wanghao6822/GL/Resource/Image/3.png

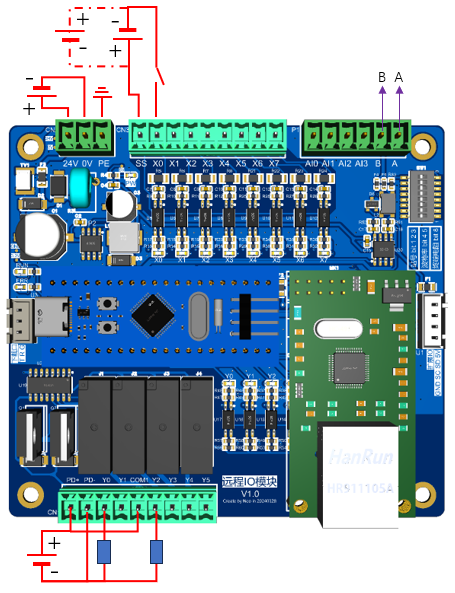
Resource/Image/3.png
