wanghao6822/GL/Resource/Image/1.jpg

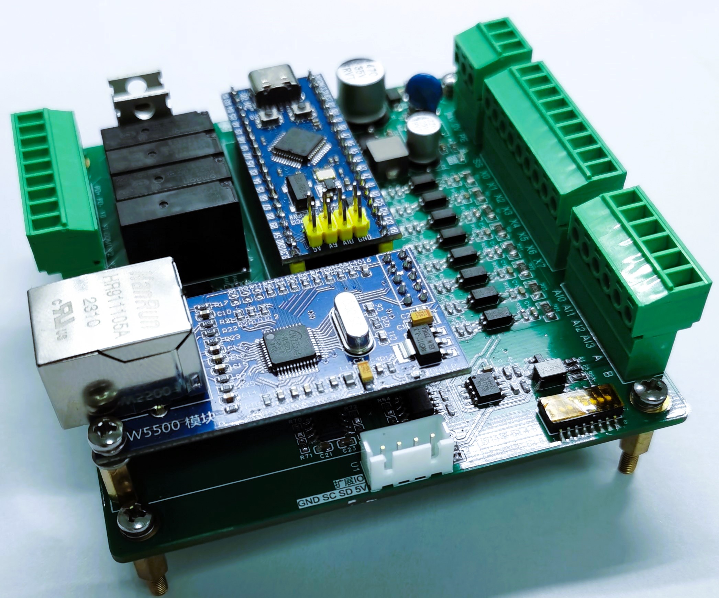
Resource/Image/1.jpg
