wanghao6822/GL/tools/项目参考文档.md

# 项目参考文档 — Modbus-IO 远程IO & 硅链调压器

> 本文档是从 `CLAUDE.md` 拆出的详细技术参考。需要完整寄存器定义、引脚表、控制算法时查阅。

---

## 技术栈

- **MCU**: STM32F103C8 (Cortex-M3)
- **框架**: Arduino + FreeRTOS
- **通信协议**: Modbus RTU (RS485) / Modbus TCP (Ethernet)
- **构建工具**: PlatformIO
- **语言**: C++

### 关键库

- Modbus-Arduino / Modbus-Serial / Modbus-Ethernet
- ADS1X15 (模拟量采集)
- PCF8575 (I2C 扩展 IO，预留)
- STM32duino FreeRTOS

---

## IO 引脚总表

### 数字输入（8路，低电平有效，已在 X_filter 任务中做消抖滤波）

| 名称 | 引脚 | 名称 | 引脚 |
| ---- | ---- | ---- | ---- |
| X0 | PB12 | X4 | PA8  |
| X1 | PB13 | X5 | PB0  |
| X2 | PB14 | X6 | PA11 |
| X3 | PB15 | X7 | PA12 |

### 数字输出（6路，开漏模式，LOW=导通/开启，HIGH=断开/关闭）

| 名称 | 引脚 | 当前用途 |
| ---- | ---- | --- |
| Y0 | PA15 | 报警输出（AlarmOutPin） |
| Y1 | PB3  | 通用输出 |
| Y2 | PB4  | 硅链控制继电器1 |
| Y3 | PB5  | 硅链控制继电器2 |
| Y4 | PB6  | 硅链控制继电器3 |
| Y5 | PB7  | 通用输出 |

### 拨码开关（5路，上拉输入，低电平=ON）

| 名称  | 引脚 | 功能 |
| ----- | ---- | --- |
| SW_B1 | PC15 | 站号 bit0 |
| SW_B2 | PA0  | 站号 bit1 |
| SW_B3 | PA1  | 站号 bit2 |
| SW_B4 | PA2  | 波特率 bit0 |
| SW_B5 | PA3  | 波特率 bit1 |

### 指示灯（开漏，低电平点亮）

| 名称 | 引脚 | 说明 |
| --- | ---- | --- |
| RUN_LED | PC14 | 每秒翻转 |
| ERROR_LED | PC13 | 看门狗复位后闪烁 |

### 通信与 I2C

| 名称 | 引脚 | 说明 |
| --- | ---- | --- |
| RS485 TX | PB10 | Modbus RTU 发送 |
| RS485 RX | PB11 | Modbus RTU 接收 |
| RS485 EN | PB1  | RS485 发送使能 |
| I2C SDA  | PB9  | ADS1115 + PCF8575 |
| I2C SCL  | PB8  | ADS1115 + PCF8575 |
| 调试 TX  | PA9  | 串口打印（需开启 UseSerialPrint 宏） |
| 调试 RX  | PA10 | 串口打印 |

---

## 模拟量输入（ADS1115，I2C 地址 0x48，增益 ±4.096V）

### 信号链路

```
高压直流(HM/KM) → 电阻分压(降压) → EXAI端子 → R64/R66(10kΩ) ─┬─→ LM358 IN+ → OUT → ADS1115 ADC
                                                     R65/R67(22kΩ)
                                                       │
                                                      GND
```

### 运放前端分压电路

| 通道 | 输入电阻 | 对地电阻 | 分压比 | 逆系数 |
|:----:|:---:|:---:|:---:|:---:|
| AI0 | R64=10kΩ | R65=22kΩ | 22/32=0.6875 | **1.4545** |
| AI1 | R66=10kΩ | R67=22kΩ | 22/32=0.6875 | **1.4545** |

### 转换公式

```
V_ADC    = ADC_value × 4.096 / 32767        (ADS1115增益=1, ±4.096V)
V_EXAI   = V_ADC × 1.4545                    (运放前端分压逆算)
V_bus    = V_EXAI × 校准系数                  (高压侧分压逆算，默认91倍)
```

即：`V_bus = ADC_value × 4.096 / 32767 × 1.4545 × calibration`

> **LM358 运放**：接成电压跟随器（OUT 直连 IN-），8脚接5V供电，4脚GND。

| 名称 | ADS1115 通道 | Modbus 寄存器 | 用途 |
| ---- | --- | --- | ---- |
| AI0  | 通道 0 | 寄存器 15 | 合母电压（HM，默认91:1分压，可通过寄存器31校准） |
| AI1  | 通道 1 | 寄存器 16 | 控母电压（KM，默认91:1分压，可通过寄存器32校准） |
| AI2  | 通道 2 | 寄存器 17 | 预留 |
| AI3  | 通道 3 | 寄存器 18 | 预留 |

---

## Modbus 保持寄存器完整映射（地址 0~32，RTU/TCP 共享）

### 基础 IO 寄存器（0~19，保持兼容）

| 地址 | 名称 | 读写 | 说明 |
| ---- | --- | ---- | --- |
| 0 | 固件版本 | R | 固定值 40501 |
| 1 | 从站 ID | R | 拨码开关 SW_B1~B3 决定 |
| 2 | 波特率状态 | R | 0=115200, 1=9600, 2=19200, 3=38400 |
| 3 | 参数操作 | R/W  | 写 10=保存, 20=重载, 30=重启, 66=恢复出厂 |
| 4 | 滤波时间 | R/W  | 默认 5ms，范围 1-100 |
| 5 | MAC 低 2 字节 | R/W  | MAC[0] + MAC[1] |
| 6 | MAC 中 2 字节 | R/W  | MAC[2] + MAC[3] |
| 7 | MAC 高 2 字节 | R/W  | MAC[4] + MAC[5] |
| 8 | IP 低 2 字节  | R/W  | IP[2].IP[3] |
| 9 | IP 高 2 字节  | R/W  | IP[0].IP[1] |
| 10 | 运行时间 | R | 设备运行秒数（0-65535 循环） |
| 11 | 输入状态 | R | bit0=X0 ... bit7=X7 |
| 12 | 输出状态 | R/W  | bit0=Y0, bit1=Y1 ... bit5=Y5（自动模式下 Y0/Y2/Y3/Y4 由硅链逻辑接管） |
| 13 | 扩展输入 | R | 预留（PCF8575 扩展 IO） |
| 14 | 扩展输出 | R/W  | 预留（PCF8575 扩展 IO） |
| 15 | AI0 原始值 | R | 合母电压 ADC 值（经91:1分压+GS8331跟随） |
| 16 | AI1 原始值 | R | 控母电压 ADC 值（经91:1分压+GS8331跟随） |
| 17 | AI2 原始值 | R | 预留模拟量 |
| 18 | AI3 原始值 | R | 预留模拟量 |
| 19 | 保留/测试 | R/W  | 看门狗测试用 |

### 硅链调压控制寄存器（20~32）

| 地址 | 名称 | 读写 | 默认值 | 范围 | 说明 |
| ---- | --- | ---- | --- | ---- | --- |
| 20 | HM 实际电压 | R | — | — | 合母电压 ×100（24300=243.00V），由 ADC 原始值 × 分压系数(9100) 换算 |
| 21 | KM 实际电压 | R | — | — | 控母电压 ×100，由 ADC 原始值 × 分压系数(9100) 换算 |
| 22 | 当前档位 | R | — | 0~7  | 当前硅链降压档位 |
| 23 | 报警状态 | R | — | 0/1  | 0=正常, 1=故障（越上限/越下限/压差异常任一触发，5s消抖） |
| 24 | 目标电压 | R/W  | 22000  | 0~30000 | 控母目标值×100（22000=220.00V），兼容110V/220V系统，超限拒绝写入  |
| 25 | 每档压降 | R/W  | 350 | 100~2000 | 每级降压默认值×100（350=3.50V），运行时动态计算实际值，超限拒绝 |
| 26 | 死区上限 | R/W  | 350 | 0~2000 | 死区上限×100（350=3.50V），运行时=动态每挡压差，超限拒绝 |
| 27 | 死区下限 | R/W  | 350 | 0~2000 | 死区下限×100（350=3.50V），运行时=动态每挡压差，超限拒绝 |
| 28 | 控制模式 | R/W  | 2 | 0~2 | 0=强制自动, 1=强制手动, 2=跟随X0硬件开关(默认)，优先级:寄存器28>X0 |
| 29 | 最大压降 | R/W  | 3500 | 500~5000 | 硅链最大降压值×100（3500=35V→220V系统，110V系统改为2100），超限拒绝 |
| 30 | 校验模式 | R/W  | 2 | 0~2 | 0=无校验(8N2), 1=偶校验(8E1), 2=奇校验(8O1)，修改后需重启，超限拒绝 |
| 31 | HM校准系数  | R/W  | 9100 | — | 合母分压比×100（9100=91.00倍），无范围限制，通过一键校准自动计算 |
| 32 | KM校准系数  | R/W  | 9100 | — | 控母分压比×100（9100=91.00倍），无范围限制，通过一键校准自动计算 |

> **参数范围校验**（参照PLC梯形图7）：写入超限值时自动回退旧值，防止误配置导致调压异常。校验在 `Save_ParameterFromRegister()` 中通过 `ClampParam()` 实现。

---

## 硅链调压控制原理

### 物理模型

```
+HM ──┬──→ 电阻分压 → AI0(ADC) → 寄存器15(原始值) → 寄存器20(HM实际电压×100)
      │
      ├──→ 硅链降压（3继电器×8档位）──→ +KM
      │         ↑
      │    Y2/Y3/Y4 继电器组
      │         ↑
      │    SetGearOutput(gear)
      │
      └──→ KM ──→ 电阻分压 → AI1(ADC) → 寄存器16(原始值) → 寄存器21(KM实际电压×100)
```

**核心概念**：控母电压 KM = 合母电压 HM − 硅链降压值。硅链调压的本质是通过切换继电器档位改变硅链降压值，使 KM 接近目标电压。

### 调压算法（等效 PLC 梯形图10 公式）

```
deviation  = TargetVoltage - KM              // 偏差（×100）
gear_steps = deviation / dynStepVoltage      // 需调整档位数
targetGear = clamp(CurrentGear ± gear_steps, 0, 7)  // 钳位到有效档位
```

| 场景 | deviation | 动作 | 效果 |
|---|:---:|---|---|
| KM < 目标 | 正 | 升档(减小降压) | KM 升高趋近目标 |
| KM > 目标 | 负 | 降档(增大降压) | KM 降低趋近目标 |
| \|deviation\| ≤ 死区 | — | 不调整 | 稳态 |

### 档位-继电器-降压值对应表（与 SCTY-D1 用户手册表3一致）

| 档位 | Y2 | Y3 | Y4 | 降压值(220V) | 降压值(110V) |
|:----:|:--:|:--:|:--:|:---:|:---:|
| G0 | 0 | 0 | 0 | 35V | 21V |
| G1 | 1 | 0 | 0 | 30V | 18V |
| G2 | 0 | 1 | 0 | 25V | 15V |
| G3 | 1 | 1 | 0 | 20V | 12V |
| G4 | 0 | 0 | 1 | 15V | 9V |
| G5 | 1 | 0 | 1 | 10V | 6V |
| G6 | 0 | 1 | 1 | 5V | 3V |
| G7 | 1 | 1 | 1 | 0V(直通) | 0V(直通) |

> 1=继电器导通/闭合(LOW)，0=继电器断开(HIGH)

### 控制模式（寄存器28）

| 值 | 含义 | 说明 |
|:--:|---|---|
| 0 | 强制自动 | 固件控制硅链，忽略X0 |
| 1 | 强制手动 | 上位机控Y2-Y5，忽略X0 |
| 2 | 跟随X0（默认） | X0=闭合→自动，X0=断开→手动 |

> **优先级**：寄存器28 > X0硬件开关。寄存器28=2时由外部硅链转换开关(X0)决定。

### 动态压差学习

- 由于硅堆制造差异，每档实际降压值并非精确等于默认值 3.50V
- 固件在每次调档后等待 1 秒，对比调前/调后 KM 电压差，计算 **实际每档压降**
- 公式：`dynStepVoltage = (KM_before - KM_after) / gear_delta`
- 动态死区 = 动态每档压差（自适应）
