wanghao6822/GL/Resource/Image/2.png

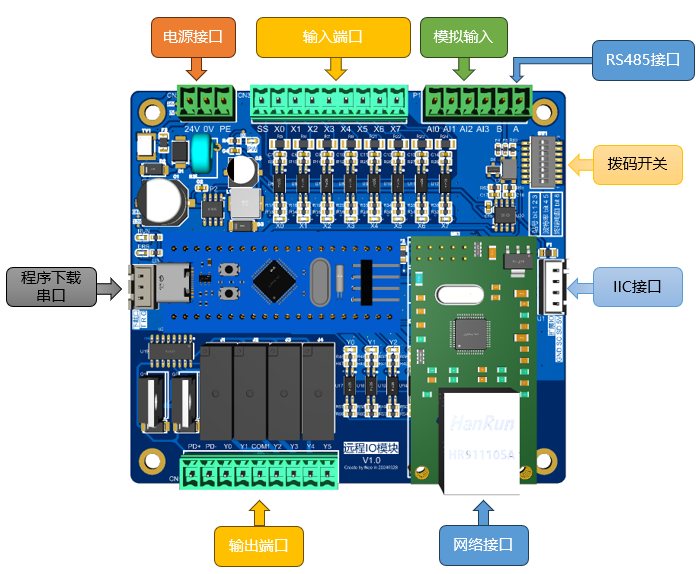
Resource/Image/2.png
