wanghao6822/GL/Resource/Image/DownloadOption.png

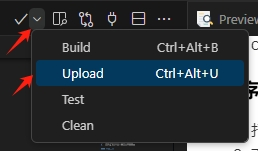
Resource/Image/DownloadOption.png
