wanghao6822/GL/include/myShowMsg.h

#ifndef _my_ShowMsg_H_
#define _my_ShowMsg_H_

#include <Arduino.h>
#include <STM32FreeRTOS.h>

// 使用串口输出信息，若不适用则注释掉
#define UseSerialPrint

#ifdef UseSerialPrint
// 创建一个互斥锁，避免串口输出时串口输出互相干扰
SemaphoreHandle_t xMutex = xSemaphoreCreateMutex();
#endif

/**
 * @brief 显示消息
 *
 * @tparam T 要显示的数据类型
 * @param msg 要显示的数据
 * @param lineNow 是否换行
 */
template <typename T>
void ShowMsg(const T &msg, bool lineNow = false)
{
#ifdef UseSerialPrint
  // 互斥锁加锁
  xSemaphoreTake(xMutex, portMAX_DELAY);
  // 输出信息
  lineNow ? Serial.println(msg) : Serial.print(msg);
  // 互斥锁解锁
  xSemaphoreGive(xMutex);
#endif
}

#endif
