wanghao6822/GL/(commit log)

2026-05-25 Modbus-IO 远程IO项目 初始版本
    [STM32远程IO引脚.xlsx]
2026-05-26 fix: 修复档位步数计算bug，新增最大压降可配置参数
    - 修复 integer division 导致偏差超过死区但不足一档时 steps=0 的卡档问题
    - 新增寄存器29(最大压降)，默认3500(220V)/改为2100(110V)，一套固件兼容双电压
    - 修正 CLAUDE.md 目标电压范围文档错误(3000~18000 → 10000~28000)
    [Parameter_Config.h, myTask.h]
2026-05-29 清理重复注释、更新引脚文档、启用串口调试打印
2026-06-02 feat: 硅链调压7档升级为8档，新增EEPROM版本校验与调试打印
    - 3继电器编码表从7档扩展到8档(0~35V→0V直通)
    - Parameter_Config新增ConfigVersion字段，EEPROM版本不匹配时自动恢复出厂
    - Wire初始化统一由IICTask管理，去除ExternalIOInitialize/IICScan中的重复调用
    - IICTask增加电压实时打印(UseSerialPrint已启用)
    - 添加PCF8575库依赖
    - 更新CLAUDE.md文档：7→8档、Y0更正为报警输出
2026-06-02 feat: 自动/手动模式改为X0硬件引脚判断，手动模式下程序脱机不控继电器
    - X0(PB12)高电平=自动模式，低电平=手动模式
    - 手动模式下Y2/Y3/Y4不写入，由外部转换开关直接控制
    - 寄存器28每秒同步X0引脚实际模式状态
    - 新增SCTY-D1项目场景概述文档
2026-06-02 fix: 清理ControlMode死字段，手动模式Y0报警统一，删除手动档位误读
2026-06-04 feat: 固件版本260604，清理死代码，优化注释，新增上位机工具集
    - 固件版本号 40501→260604，格式改为2位年+2位月+2位日
    - 删除 dead code（OutputEnum引用、空else分支）
    - 档位表注释简化，硅链参数保存段补注释
    - .gitignore 增加 __pycache__/ 和 .pio/libdeps
    - 新增上位机监控软件 + Modbus 调试工具集 (tools/)
2026-06-05 fix: 修复5个代码缺陷 — 除以零保护、溢出修复、整数ADC、static隔离、注释修正
    - 致命: StepVoltage÷0 加零值保护，防止 HardFault 崩溃
    - 中等: 越上限报警改为 int32_t 运算，避免 uint16_t 溢出
    - 性能: ADCToVoltage 浮点→整数(64位)，无FPU下更快
    - 健壮: 所有头文件函数加 static，防止未来 ODR 链接冲突
    - 文档: 修正寄存器10→11的注释错误
    [IO_Setting.h, Parameter_Config.h, myADS1115.h, myModbus.h, myTask.h]
2026-06-05 docs: 重写 README — 完整硬件规格、硅链调压器说明、全寄存器映射、快速开始指南
2026-06-05 chore: 项目目录清理 — 删除废弃文件、移除C#上位机、完善.gitignore
    删除:
    - src/temp.txt, include/temp.txt (废弃代码片段)
    - include/README, lib/README, test/README (PlatformIO模板)
    - remote-ioguide/ (已废弃的C#上位机, 35个文件)
    - 空目录 lib/, test/
    .gitignore 更新:
    - .pio/ 替代 .pio/build + .pio/libdeps
    - 新增 .serena/ 排除工具缓存
    - 取消追踪 .pio/.../integrity.dat
2026-06-09 fix: 更新分压系数 — 99:1→91:1，适配新PCB电阻分压+GS8331跟随电路
    - Parameter_Config.h: HM_Calibration/KM_Calibration 默认值 9900→9100
    - IO_Setting.h: ADCToVoltage 注释同步更新
    - CLAUDE.md: 文档对齐新电路参数（3×300kΩ+10kΩ, 分压比91:1）
    [IO_Setting.h, Parameter_Config.h]
2026-06-09 feat: 新增Modbus校验位可配置(寄存器30)，完善README文档，上位机增加校验位选择
    - 固件: 新增寄存器30(ParityMode)，支持8N2/8E1/8O1切换，EEPROM掉电保存
    - 固件: ConfigVersion升级到v3，兼容旧版EEPROM数据迁移
    - 文档: README大幅扩展(面试要点/算法详解/架构说明)
    - 文档: CLAUDE.md同步更新寄存器映射表
    - 工具: 上位机通信设置栏新增校验位下拉选择
    - 工具: modbus_poll.py寄存器范围同步更新(20~29→20~30)
    - 新增: RemoteIOGuide .NET项目目录
2026-06-11 feat: 代码梳理+双源优先级+参数校验+PLC合规模拟
    固件改动:
    - 清理 myTask.h 死代码和误导注释，新增完整算法文档注释
    - IO_Setting.h 继电器编码表注释与SCTY-D1手册对齐
    - Parameter_Config.h: ControlMode默认值0→2(跟随X0硬件开关)
    - 手/自动模式双源优先级: 寄存器28 > X0硬件开关
    - 参数写入范围校验(ClampParam)，超限自动回退旧值
    - 修复寄存器28每秒被effMode覆盖的Bug
    上位机改动:
    - 数字输出三行布局: Y0/Y1 | Y2/Y3/Y4(硅链) | Y5
    - 控制模式下拉框三态: 强制自动/强制手动/跟随X0硬件
    - 参数区增加范围提示和默认值显示
    - 监测面板增加目标电压和动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
    [IO_Setting.h, Parameter_Config.h, modbus_poll.py, myTask.h, simulate_regulation.py, 硅链控制板_上位机.py]
2026-06-12 fix: 校准后自动保存EEPROM，解决校准系数不生效问题
2026-06-12 fix: 校准范围与固件对齐(1000~20000)，新增重置默认按钮
2026-06-12 fix: 取消HM/KM校准系数范围限制，校准公式不再受限
2026-06-12 feat: 模拟量电路设计文档+ADC公式加入1.4545运放前端分压系数
    - CLAUDE.md: 新增完整模拟信号链路文档(R64/R65分压+LM358跟随+ADS1115)
    - IO_Setting.h: ADCToVoltage公式加入32/22(1.4545)运放前端分压逆算
2026-06-12 fix: ADCToVoltage返回uint32_t防溢出截断 — 极端校准系数下中间值超65535被uint16截断导致恶性循环Bug
    [IO_Setting.h, myTask.h]
2026-06-17 docs: 精简CLAUDE.md，详细参考移至tools/项目参考文档.md
    - 根级CLAUDE.md仅保留项目概述、角色、核心功能、关键引脚速查
    - 详细引脚表、寄存器映射、硅链控制原理等移至tools/项目参考文档.md
    - 减少AI上下文窗口占用，提升响应效率
2026-06-17 feat(上位机): X0手动/自动切换动画+自动模式锁定硅链输出+动态档位降压显示
    - X0区域改为手动/自动双框切换动画，X0标签放下方
    - 生效模式联动X0电平: 跟随X0时实时显示"自动·X0闭合"或"手动·X0断开"
    - 自动模式下Y2/Y3/Y4硅链输出锁定(禁用勾选+🔒标识)
    - 新增_is_effective_auto()辅助方法统一模式判定
    - 档位栏G0~G7降压值改为动态压差计算: (7-档位)×dynStepVoltage
    - _toggle_output增加自动模式拦截守卫
2026-06-18 fix: GPIO初始化禁用JTAG释放PA15/PB3/PB4为GPIO
    - PA15(JTDI)→Y0报警, PB3(JTDO)→Y1, PB4(JNTRST)→Y2硅链均被JTAG占用
    - 写入AFIO->MAPR SWJ_CFG=010: 禁用JTAG-DP,保留SW-DP(ST-Link调试)
    - 解决问题: Y0开漏输出HIGH时引脚被JTAG内部上拉干扰导致光耦异常导通
    [IO_Setting.h]
2026-06-26 feat: 动态压降范围限制1~5V + 上位机打包 + 项目交接文档
    - fix: 动态压降dynStepVoltage钳位至1V~5V，超范围回退3.50V
    - fix: 上位机参数范围提示同步更新(每档压降/死区 1~5V)
    - feat: 上位机PyInstaller打包为独立exe，脱离Python环境运行
    - feat: 新增build_exe.bat一键重新打包脚本
    - chore: .gitignore排除PyInstaller构建产物
    - docs: 新增项目交接文档(硬件/软件/代码导读/FAQ)
    [myTask.h, 硅链控制板_上位机.py]
2026-06-26 feat: 新增一键烧录工具 flash_stlink.bat + 预编译固件
    - 双击 flash_stlink.bat 即可烧录，无需打开VSCode
    - 使用PlatformIO内置OpenOCD + ST-Link直接烧录
    - 预编译固件 firmware.hex/bin 存放在 tools/firmware/
    - 烧录后自动校验并复位运行
2026-06-26 fix: 批处理脚本去中文化，解决新Windows系统乱码和命令解析错误
    - flash_stlink.bat: 全部改为ASCII字符
    - build_exe.bat: 全部改为ASCII字符
    - setup_new_pc.bat: 全部改为ASCII字符
    - 根因: chcp 65001 + 中文字符在纯净Windows上导致命令解析异常
2026-06-26 feat: 新增Modbus库修复脚本 fix_modbus_lib.bat
2026-06-26 fix: 修复Modbus库补丁脚本 - 改用预修补文件直接覆盖，100%可靠
2026-06-26 refactor: Modbus-Arduino库本地化(vendoring)，消除新电脑编译问题
    - 将修补后的Modbus-Arduino库放入lib/目录
    - PlatformIO优先使用本地lib/，不再下载原版库
    - 删除fix_modbus_lib.bat和Modbus_Patched.h（不再需要）
    - 重写setup_new_pc.bat：自动检测路径+中文路径检查+4步安装
    - 新电脑只需双击setup_new_pc.bat即可完成全流程配置
